jitendraphand/ziggy/docs/REFERENCES.md

<!-- SPDX-License-Identifier: CC-BY-4.0 -->
# Primary references (checked 2026-11-07)

* ELEGOO Neptune 4 Max product page and specs (420×420×480 mm): https://www.elegoo.com/products/neptune-4-max-fdm-3d-printer
* ELEGOO Wiki Neptune 4 Max FAQ: https://wiki.elegoo.com/en/faq/neptune-4-max-faq
* CubeMars AK80-64 KV80 (48/120 N·m, 64:1, 850 g, single 14-bit encoder): https://www.cubemars.com/product/ak80-64-kv80-robotic-actuator.html
* CubeMars AK70-10 (8.3/24.8 N·m; AK series table on the same site): https://www.cubemars.com/
* RobStride 04 user manual (40/120 N·m, 9:1, dual encoders, 15–60 VDC): https://torquemicro.com/products/robstride-04-motor
* MuJoCo documentation: https://mujoco.readthedocs.io/ and repository https://github.com/google-deepmind/mujoco
* CadQuery documentation: https://cadquery.readthedocs.io/ and repository https://github.com/CadQuery/cadquery
* CERN-OHL-S v2: https://ohwr.org/cern_ohl_s_v2.txt · Apache-2.0: https://www.apache.org/licenses/LICENSE-2.0
* ISO 13482 (personal care robots, safety) and ISO 10218 (industrial robots): standards for guidance; not reproduced here
* CubeMars AK80-64 2D drawing (interface dims used in cad/lower_body.py): https://www.cubemars.com/data/cms/202602/ak80-64-robotic-actuator-2d-drawing.pdf
* SKF 6004-2RSH deep groove ball bearing (20×42×12, C 9.95 kN, C0 5 kN): https://www.skf.com/
* Unitree H1 public specifications (benchmark reference only): https://www.unitree.com/h1 and https://support.unitree.com/
