jitendraphand/ziggy/media/push_com_trace.png

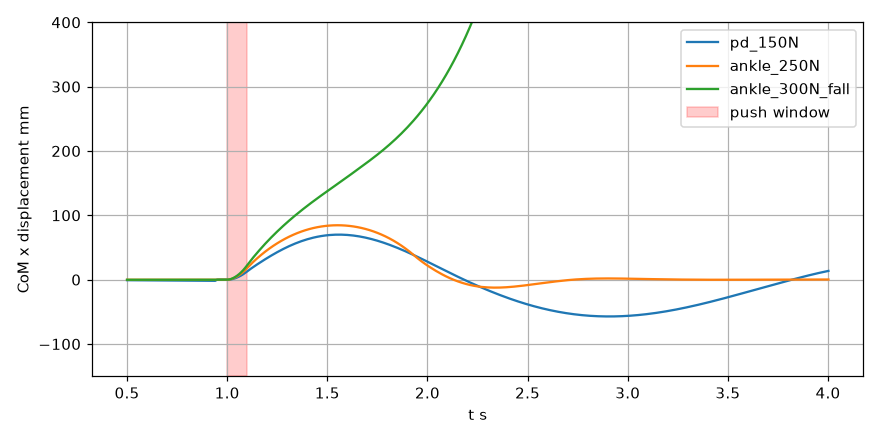
media/push_com_trace.png
