jitendraphand/ziggy/media/push_compare.png

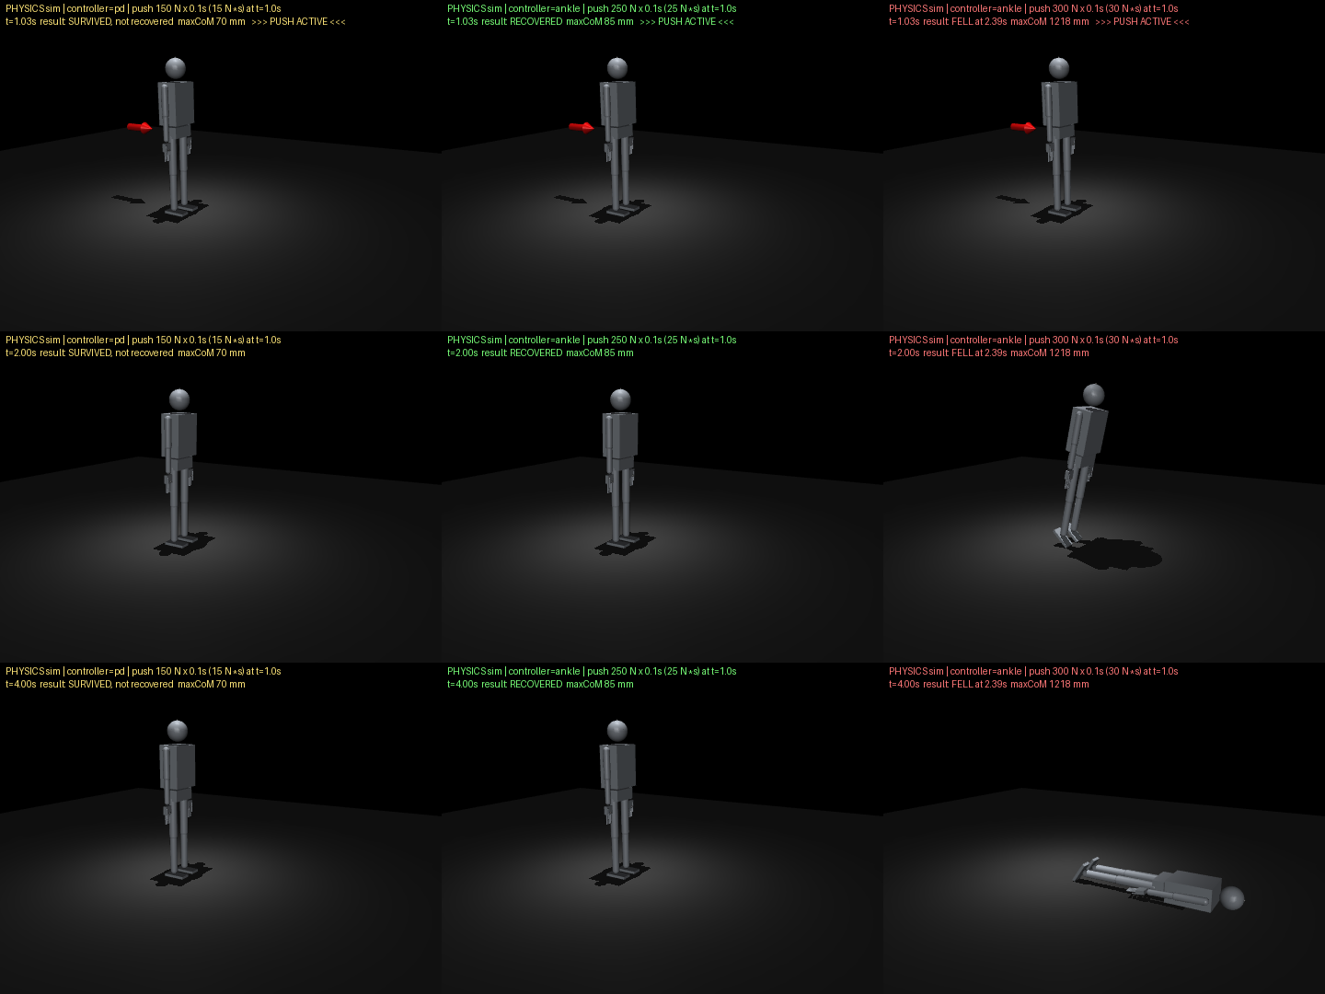
media/push_compare.png
