jitendraphand/ziggy/hardware/lower_body/step/KN-SPC-L.step

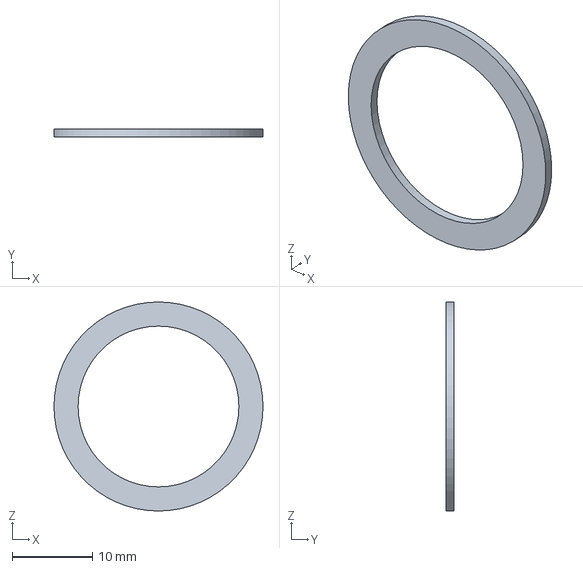
[picture p12: CAD file, 2026-11-07]
hardware/lower_body/step/KN-SPC-L.step
26.0 x 1.00 x 26.0 mm
