jitendraphand/ziggy/hardware/step/forearm_cover_half.step

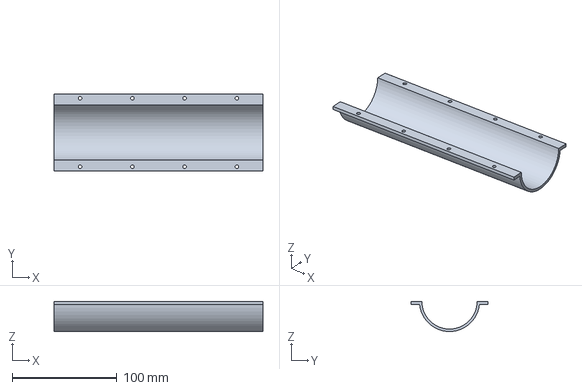
[picture p13: CAD file, 2026-11-07]
hardware/step/forearm_cover_half.step
200.0 x 73.6 x 28.8 mm
