jitendraphand/ziggy/hardware/lower_body/step/HR-BCOV-L.step

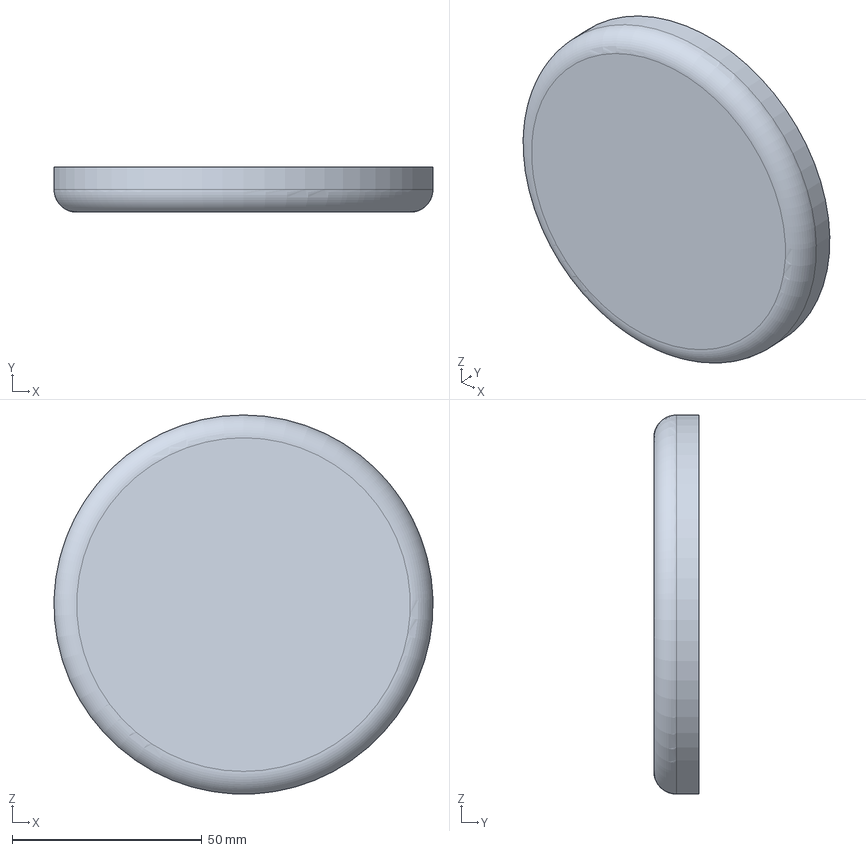
[picture p14: CAD file, 2026-11-07]
hardware/lower_body/step/HR-BCOV-L.step
100.0 x 12.0 x 100.0 mm
