jitendraphand/ziggy/hardware/step/phalanx_distal.step

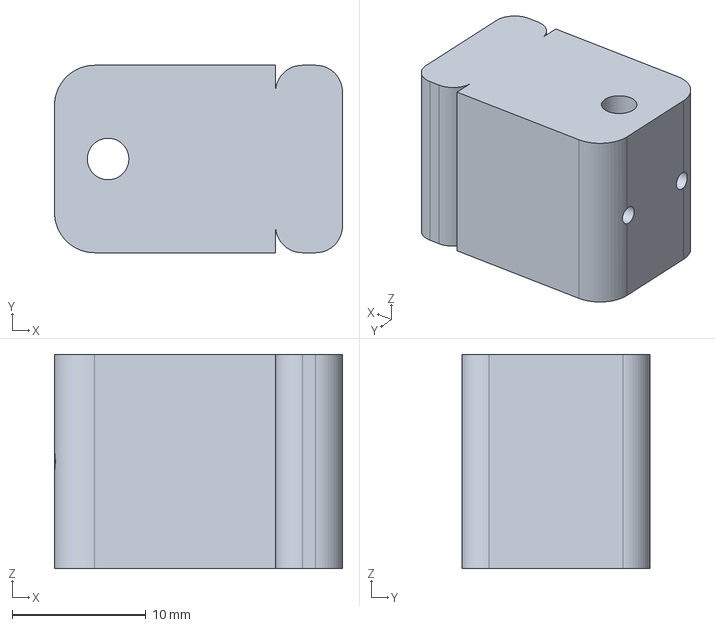
[picture p15: CAD file, 2026-11-07]
hardware/step/phalanx_distal.step
21.5 x 14.0 x 16.0 mm
