jitendraphand/ziggy/hardware/lower_body/step/HR-CAP-L.step

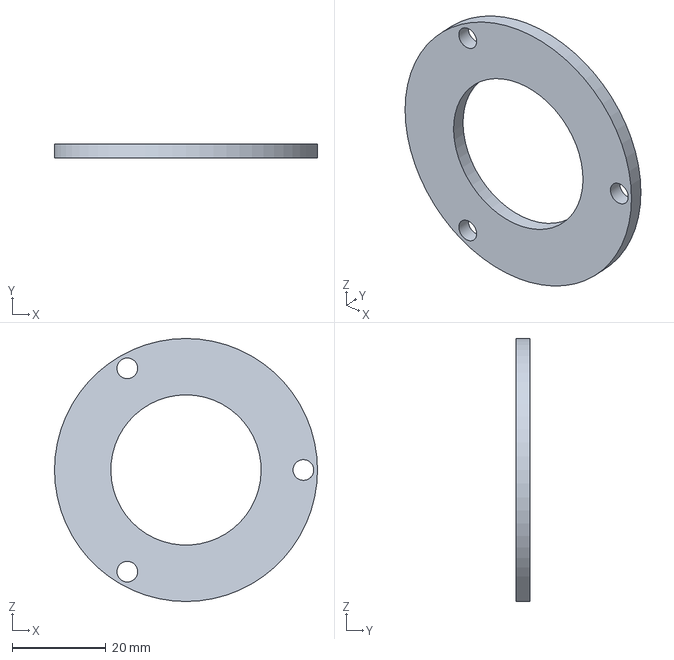
[picture p16: CAD file, 2026-11-07]
hardware/lower_body/step/HR-CAP-L.step
56.0 x 3.00 x 56.0 mm
