jitendraphand/ziggy/hardware/step/coupon_tube_fit.step

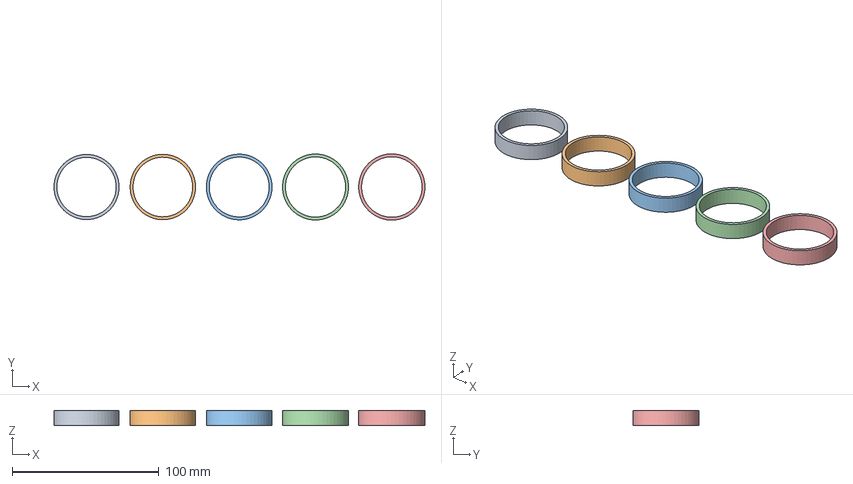
[picture p17: CAD file, 2026-11-07]
hardware/step/coupon_tube_fit.step
252.8 x 45.2 x 10.0 mm
