jitendraphand/ziggy/hardware/lower_body/step/HR-ARA-L.step

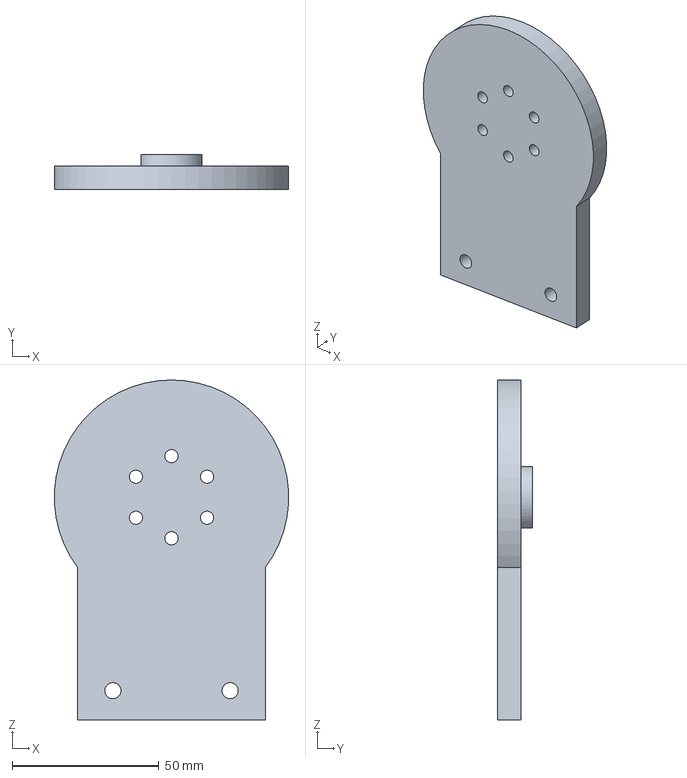
[picture p18: CAD file, 2026-11-07]
hardware/lower_body/step/HR-ARA-L.step
79.9 x 12.0 x 116.0 mm
