jitendraphand/ziggy/hardware/step/pelvis_cover.step

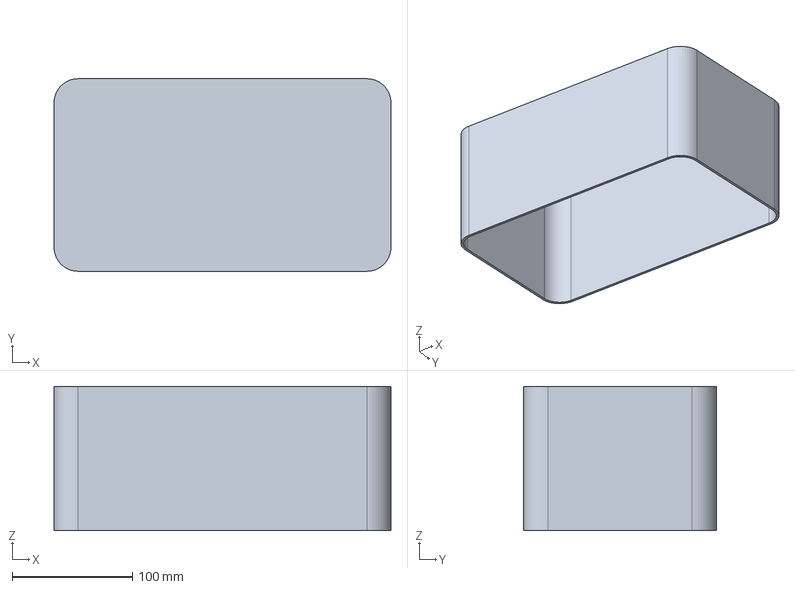
[picture p19: CAD file, 2026-11-07]
hardware/step/pelvis_cover.step
280.0 x 160.0 x 120.0 mm
