jitendraphand/ziggy/hardware/lower_body/step/THIGH-TUBE-L.step

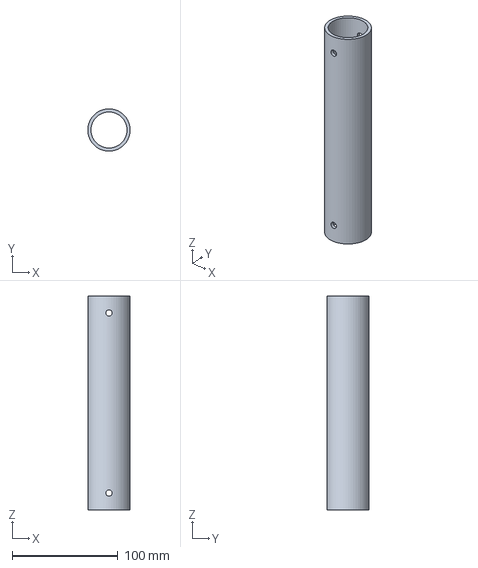
[picture p20: CAD file, 2026-11-07]
hardware/lower_body/step/THIGH-TUBE-L.step
40.0 x 40.0 x 202.0 mm
