jitendraphand/ziggy/hardware/step/coupon_holes.step

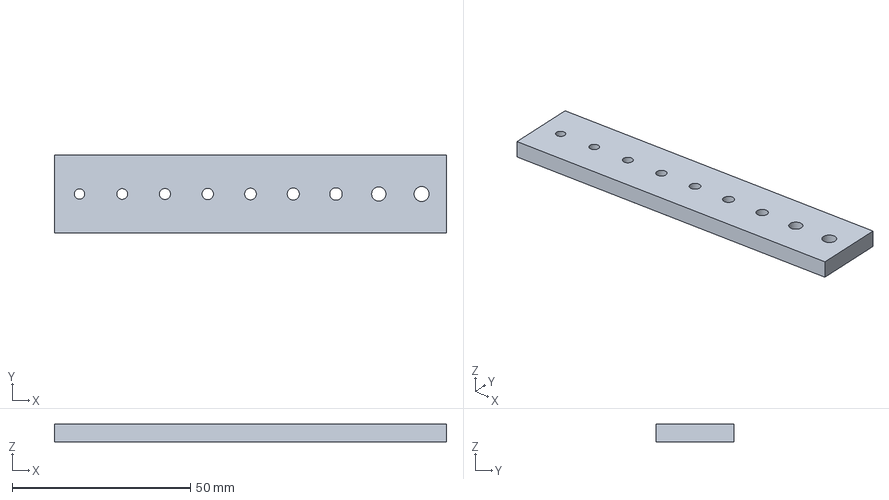
[picture p21: CAD file, 2026-11-07]
hardware/step/coupon_holes.step
110.0 x 22.0 x 5.00 mm
