jitendraphand/ziggy/hardware/lower_body/step/KN-ACT-L.step

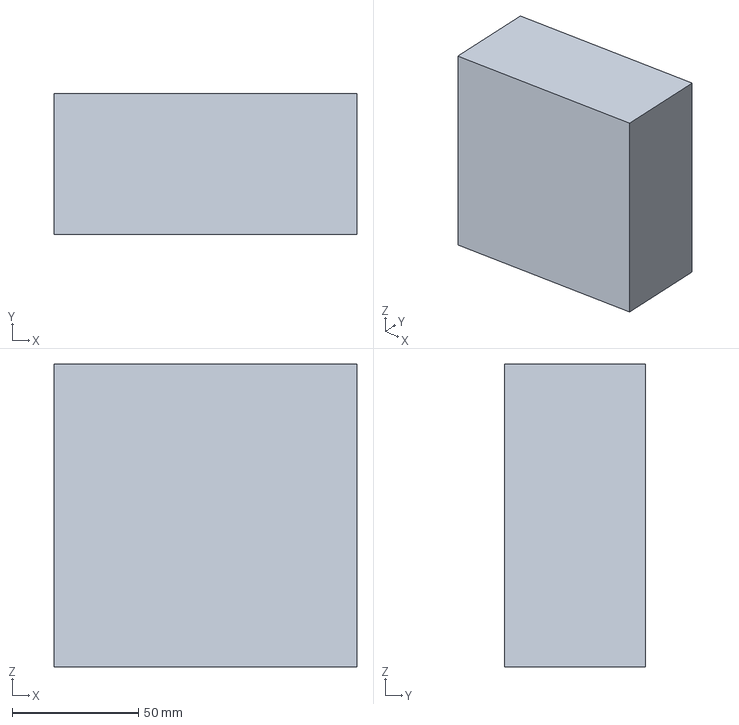
[picture p22: CAD file, 2026-11-07]
hardware/lower_body/step/KN-ACT-L.step
120.0 x 56.0 x 120.0 mm
