jitendraphand/ziggy/hardware/step/estop_mount.step

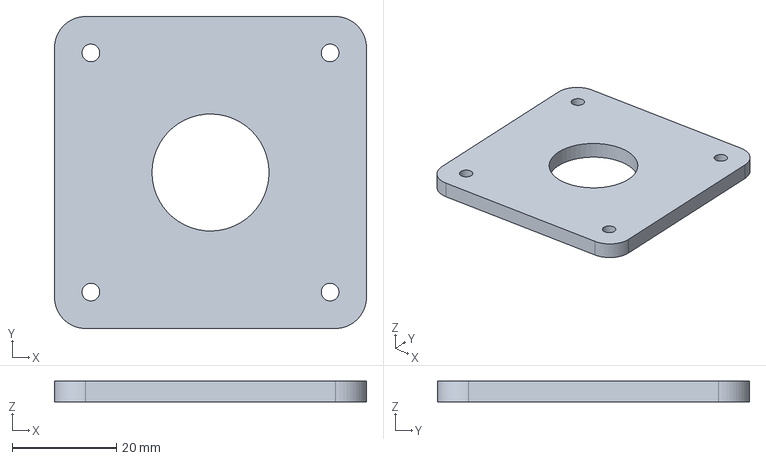
[picture p23: CAD file, 2026-11-07]
hardware/step/estop_mount.step
60.0 x 60.0 x 4.00 mm
