jitendraphand/ziggy/hardware/lower_body/step/KN-PBR-L.step

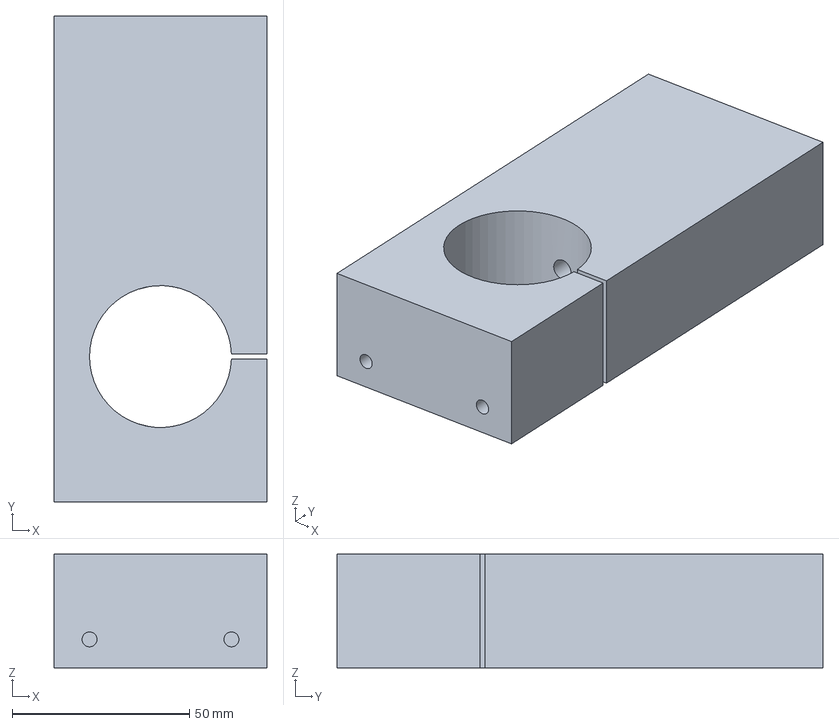
[picture p24: CAD file, 2026-11-07]
hardware/lower_body/step/KN-PBR-L.step
60.0 x 137.0 x 32.0 mm
