jitendraphand/ziggy/hardware/step/phalanx_proximal.step

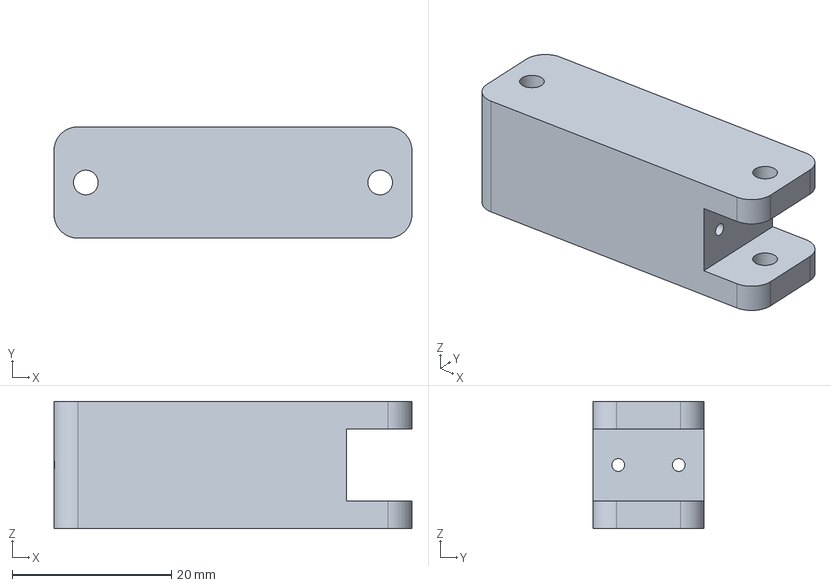
[picture p25: CAD file, 2026-11-07]
hardware/step/phalanx_proximal.step
45.0 x 14.0 x 16.0 mm
