jitendraphand/ziggy/hardware/lower_body/step/AP-PLB-L.step

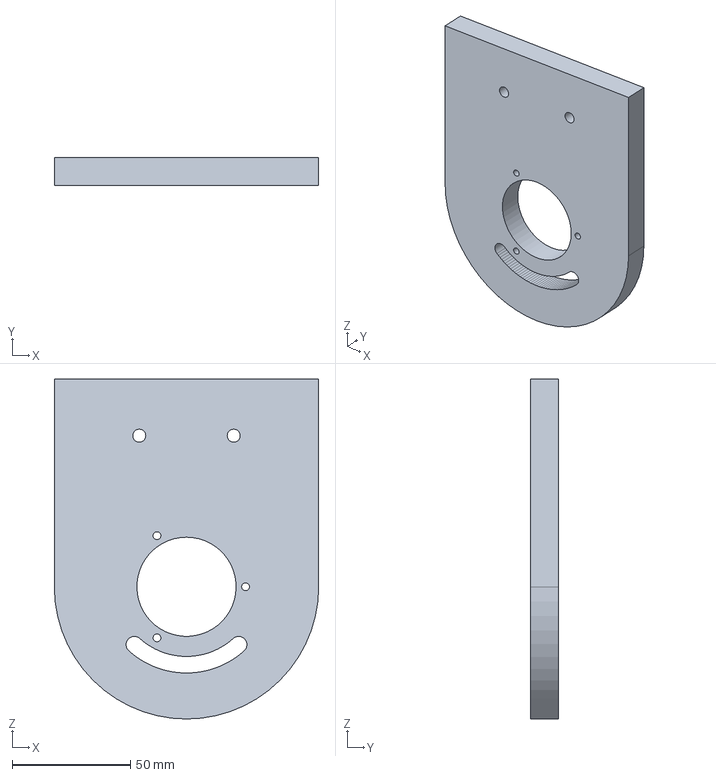
[picture p26: CAD file, 2026-11-07]
hardware/lower_body/step/AP-PLB-L.step
112.0 x 12.0 x 144.0 mm
