jitendraphand/ziggy/hardware/step/foot_cover.step

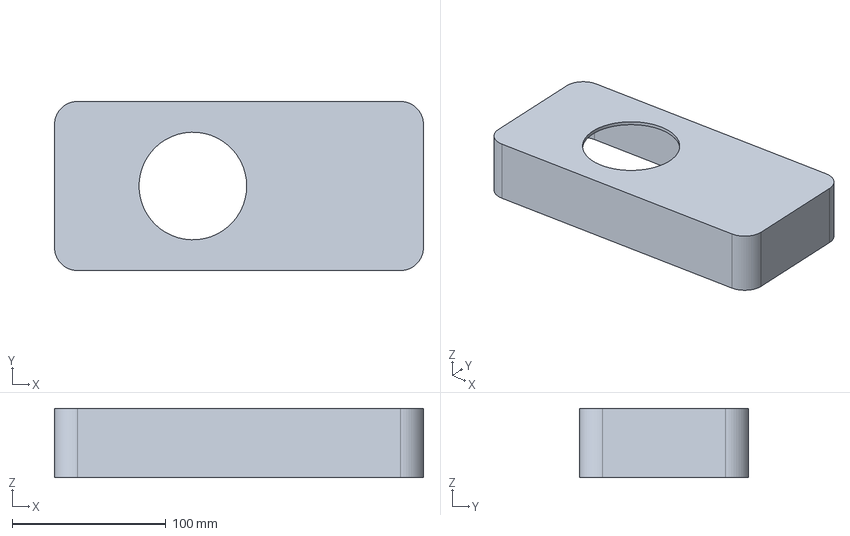
[picture p27: CAD file, 2026-11-07]
hardware/step/foot_cover.step
240.0 x 110.0 x 45.0 mm
