jitendraphand/ziggy/hardware/lower_body/step/KN-BRG-L.step

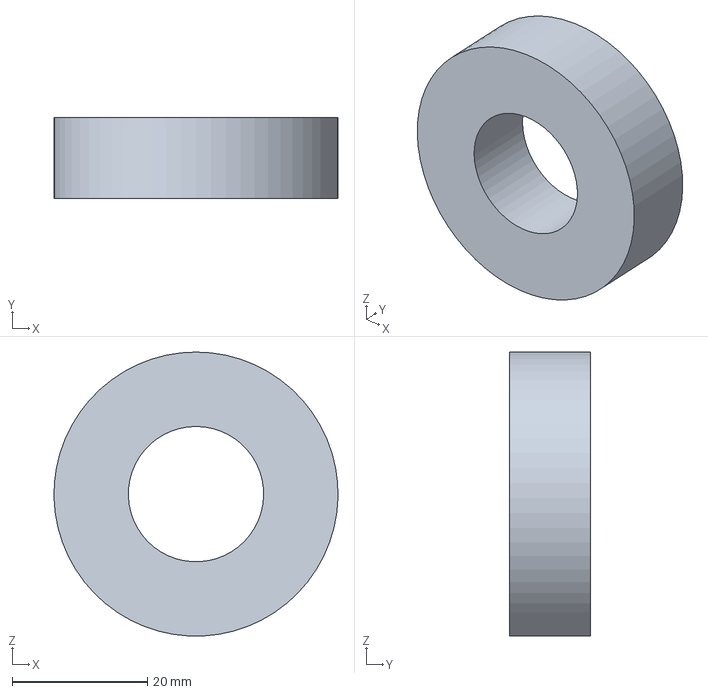
[picture p28: CAD file, 2026-11-07]
hardware/lower_body/step/KN-BRG-L.step
42.0 x 12.0 x 42.0 mm
