jitendraphand/ziggy/hardware/step/torso_shell_front.step

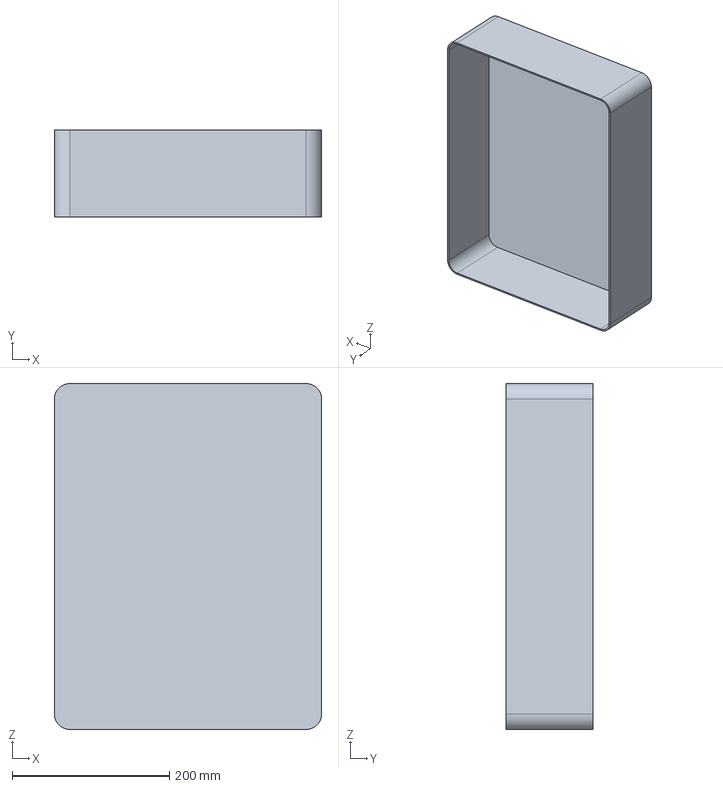
[picture p29: CAD file, 2026-11-07]
hardware/step/torso_shell_front.step
340.0 x 110.0 x 440.0 mm
