jitendraphand/ziggy/hardware/lower_body/step/SHIN-TUBE-L.step

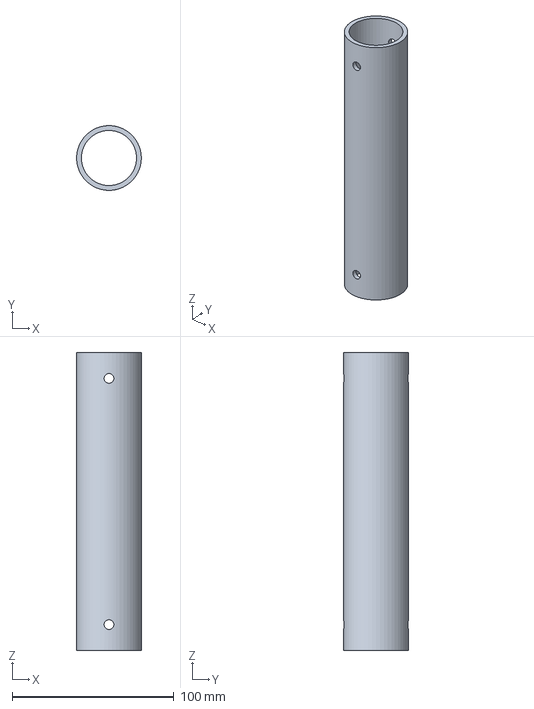
[picture p30: CAD file, 2026-11-07]
hardware/lower_body/step/SHIN-TUBE-L.step
40.0 x 40.0 x 184.0 mm
