jitendraphand/ziggy/hardware/step/upper_arm_cover_half.step

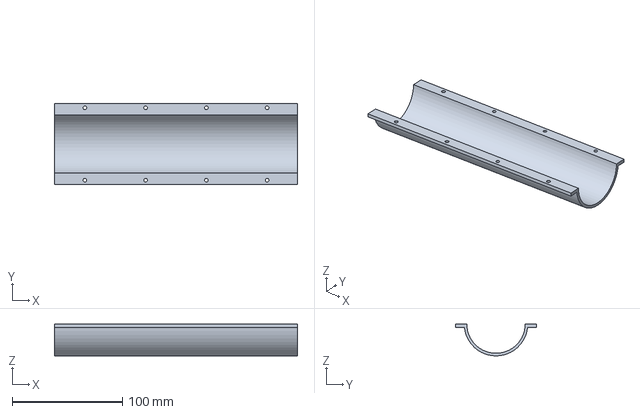
[picture p31: CAD file, 2026-11-07]
hardware/step/upper_arm_cover_half.step
220.0 x 73.6 x 28.8 mm
