jitendraphand/ziggy/hardware/lower_body/step/HP-PLA-L.step

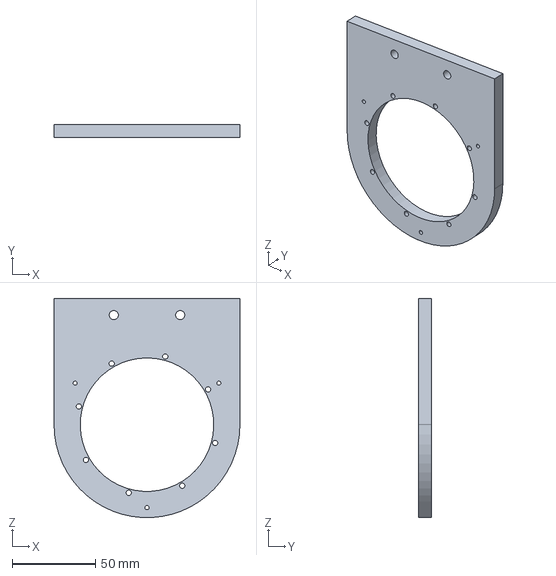
[picture p32: CAD file, 2026-11-07]
hardware/lower_body/step/HP-PLA-L.step
112.0 x 8.00 x 131.9 mm
