jitendraphand/ziggy/hardware/step/actuator_cover_ak80.step

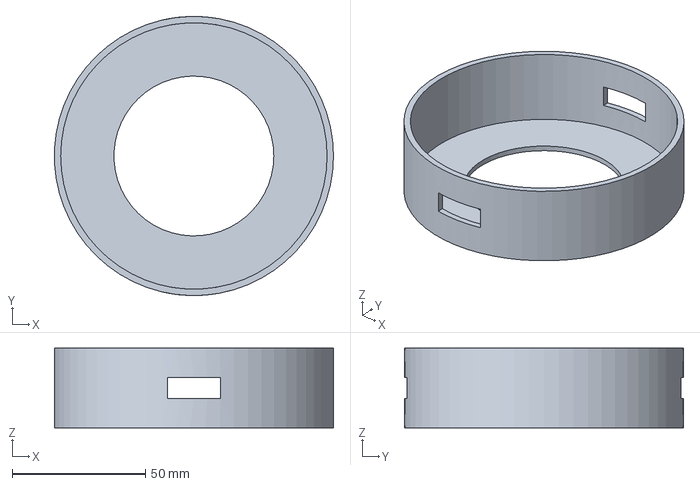
[picture p33: CAD file, 2026-11-07]
hardware/step/actuator_cover_ak80.step
104.7 x 104.8 x 30.0 mm
