jitendraphand/ziggy/hardware/lower_body/step/HR-PBR-L.step

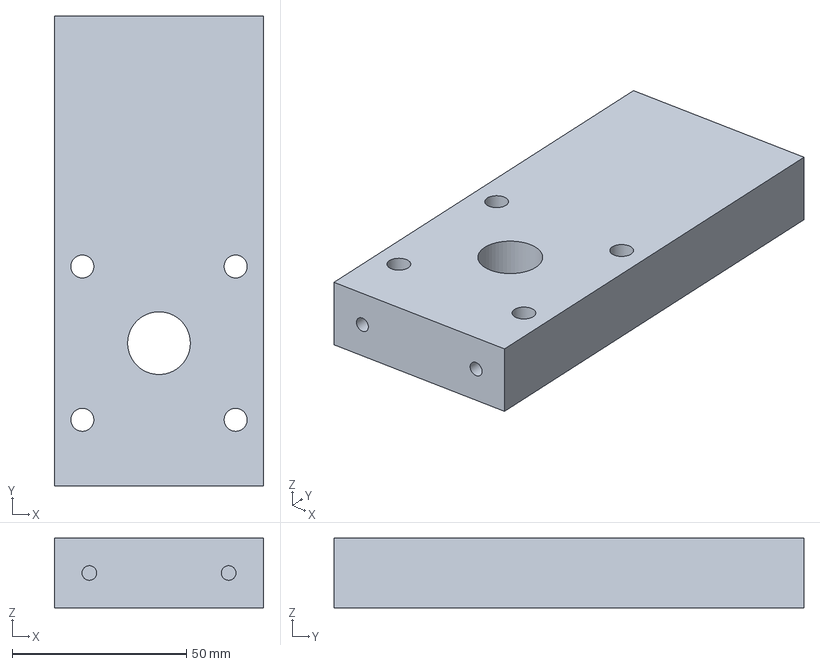
[picture p34: CAD file, 2026-11-07]
hardware/lower_body/step/HR-PBR-L.step
60.0 x 134.9 x 20.0 mm
