jitendraphand/ziggy/hardware/lower_body/step/HP-RCAP-L.step

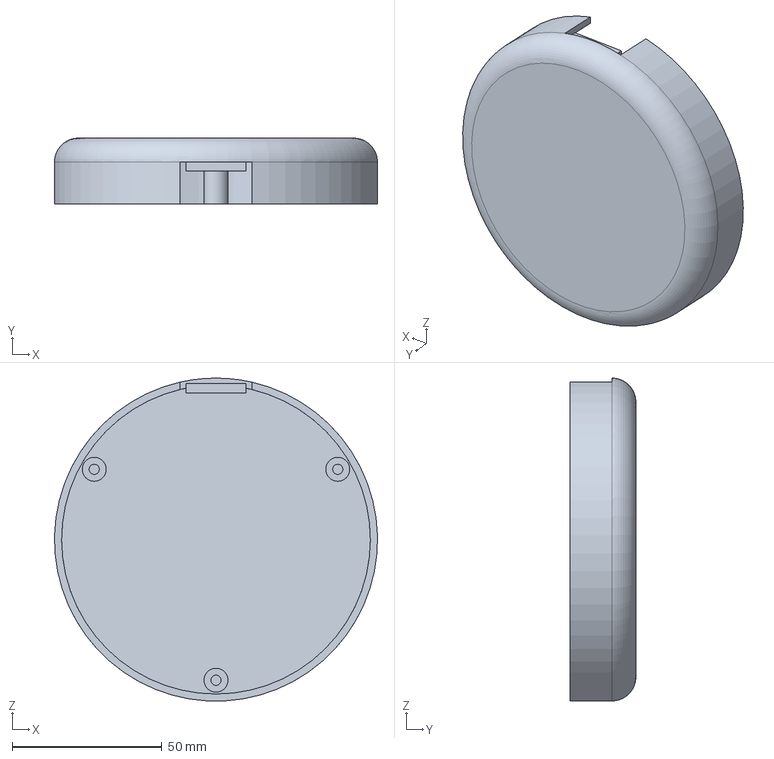
[picture p35: CAD file, 2026-11-07]
hardware/lower_body/step/HP-RCAP-L.step
108.0 x 22.0 x 107.9 mm
