jitendraphand/ziggy/hardware/step/cable_clip_tube40.step

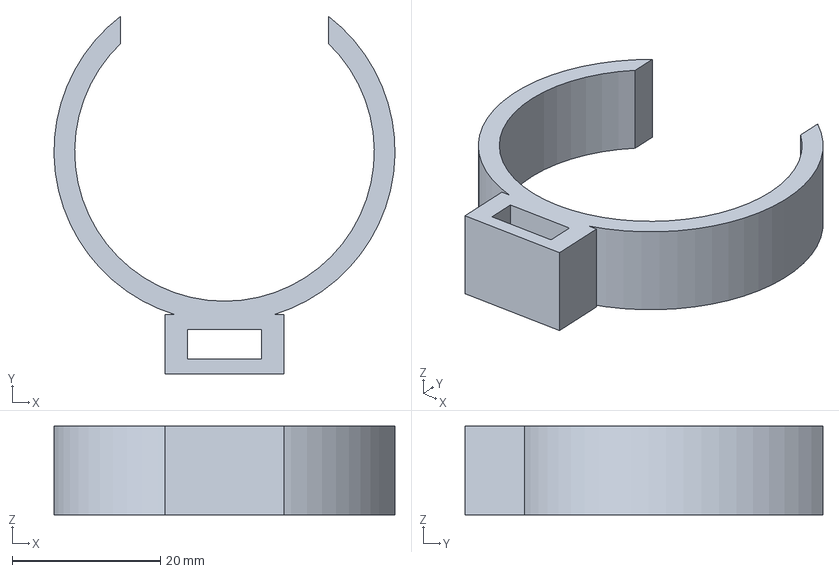
[picture p36: CAD file, 2026-11-07]
hardware/step/cable_clip_tube40.step
46.0 x 48.2 x 12.0 mm
