jitendraphand/ziggy/hardware/lower_body/step/AR-DBR-L.step

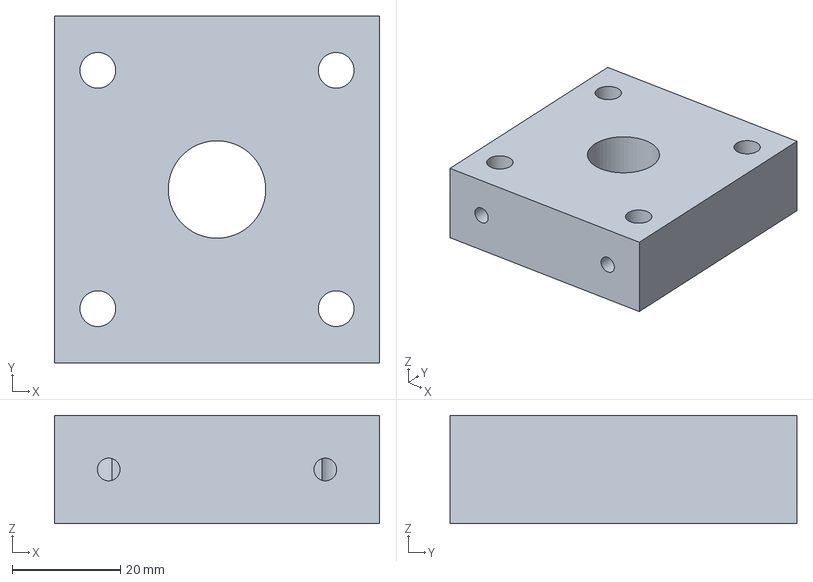
[picture p37: CAD file, 2026-11-07]
hardware/lower_body/step/AR-DBR-L.step
60.0 x 64.0 x 20.0 mm
