jitendraphand/ziggy/hardware/step/thigh_cover_half.step

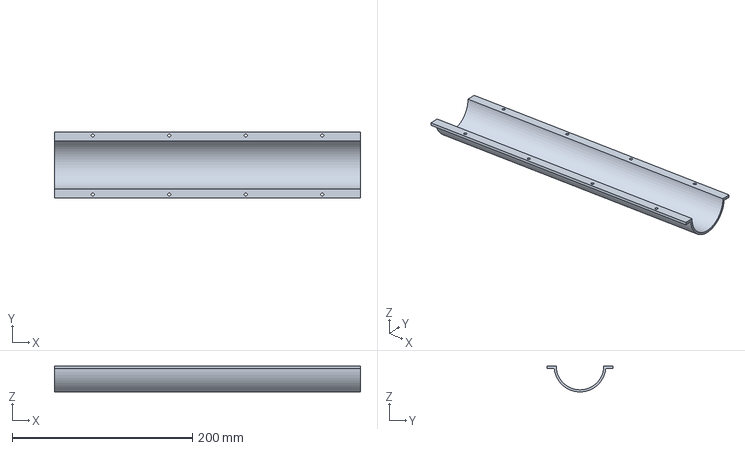
[picture p38: CAD file, 2026-11-07]
hardware/step/thigh_cover_half.step
340.0 x 73.6 x 28.8 mm
