jitendraphand/ziggy/hardware/step/head_shell_half.step

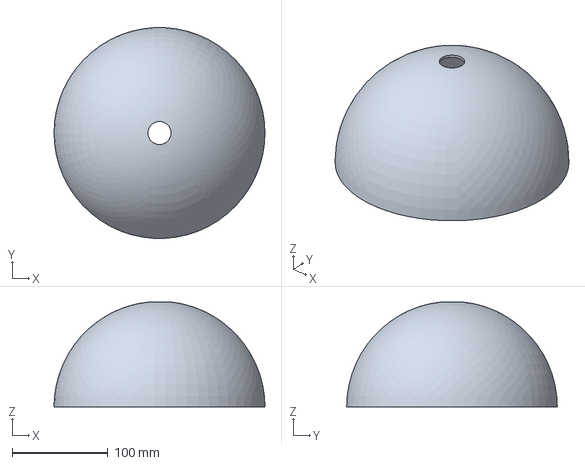
[picture p39: CAD file, 2026-11-07]
hardware/step/head_shell_half.step
220.0 x 219.7 x 109.3 mm
