jitendraphand/ziggy/hardware/lower_body/step/KN-DBR-L.step

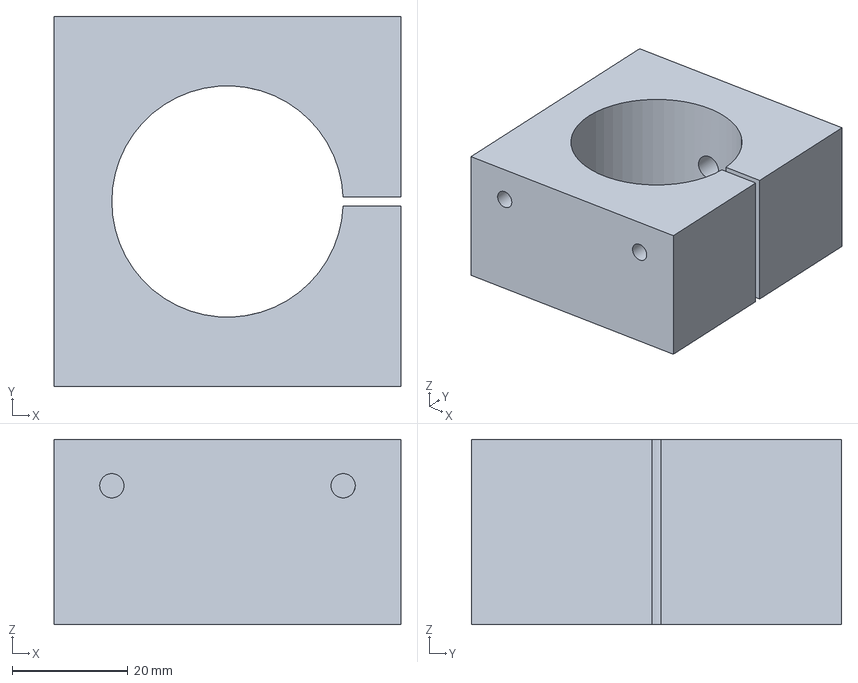
[picture p40: CAD file, 2026-11-07]
hardware/lower_body/step/KN-DBR-L.step
60.0 x 64.0 x 32.0 mm
