jitendraphand/ziggy/hardware/step/foot_sole_pad.step

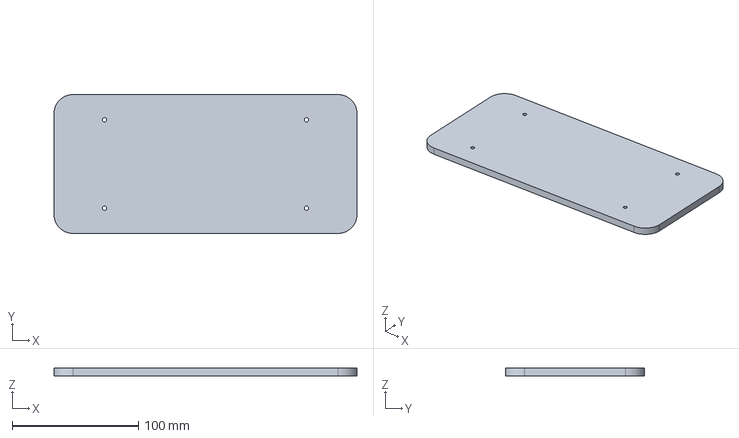
[picture p41: CAD file, 2026-11-07]
hardware/step/foot_sole_pad.step
240.0 x 110.0 x 6.00 mm
