jitendraphand/ziggy/hardware/step/shin_cover_half.step

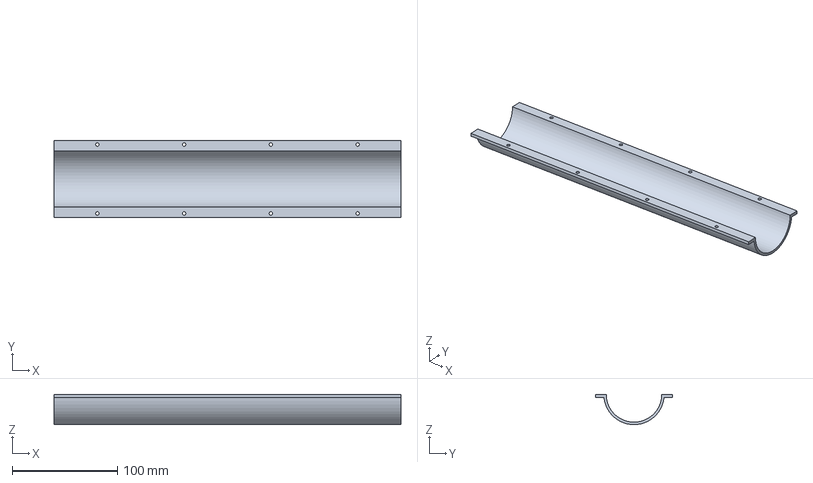
[picture p42: CAD file, 2026-11-07]
hardware/step/shin_cover_half.step
330.0 x 73.6 x 28.8 mm
