jitendraphand/ziggy/hardware/lower_body/step/KN-ARB-L.step

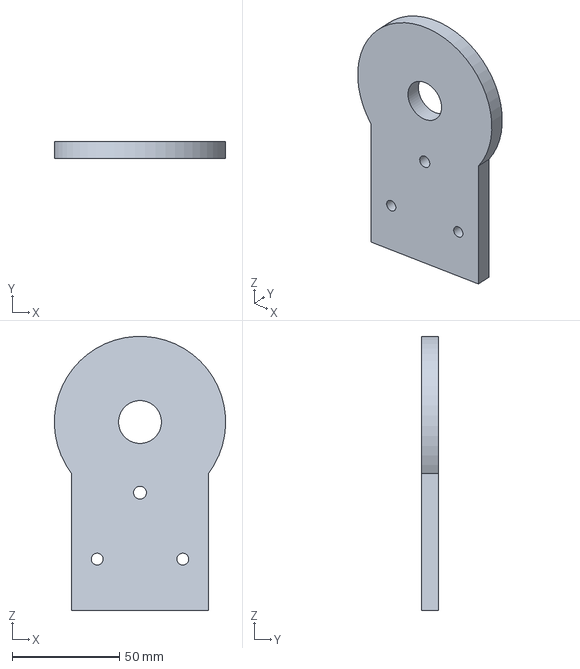
[picture p43: CAD file, 2026-11-07]
hardware/lower_body/step/KN-ARB-L.step
79.9 x 8.00 x 127.9 mm
