jitendraphand/ziggy/hardware/step/phalanx_middle.step

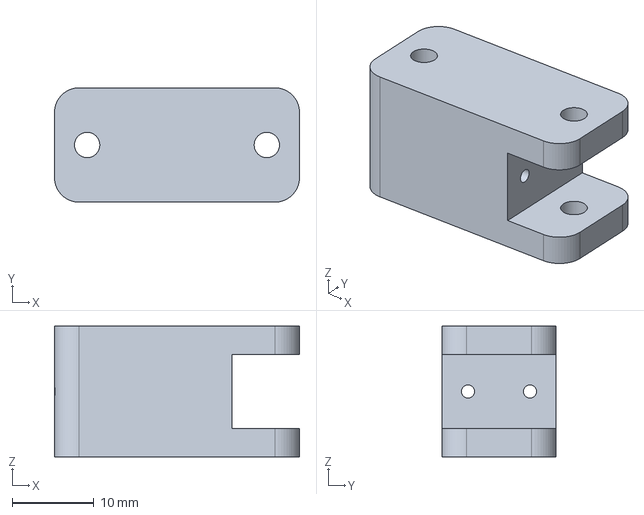
[picture p44: CAD file, 2026-11-07]
hardware/step/phalanx_middle.step
30.0 x 14.0 x 16.0 mm
