jitendraphand/ziggy/hardware/lower_body/step/KN-PIN-L.step

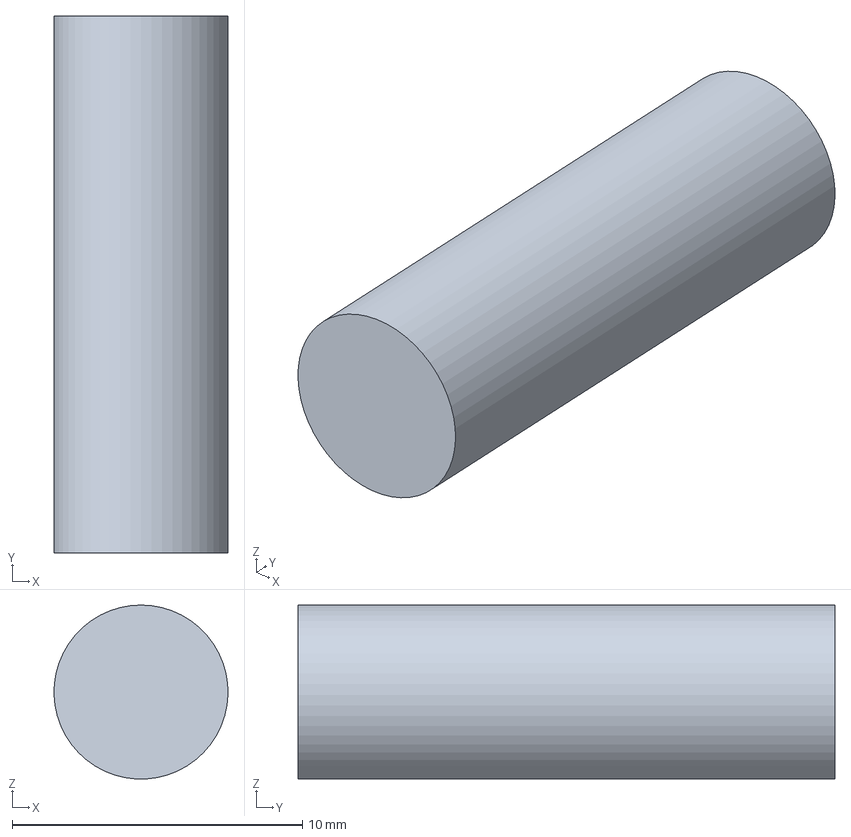
[picture p45: CAD file, 2026-11-07]
hardware/lower_body/step/KN-PIN-L.step
6.00 x 18.5 x 5.99 mm
