jitendraphand/ziggy/hardware/step/tendon_spool.step

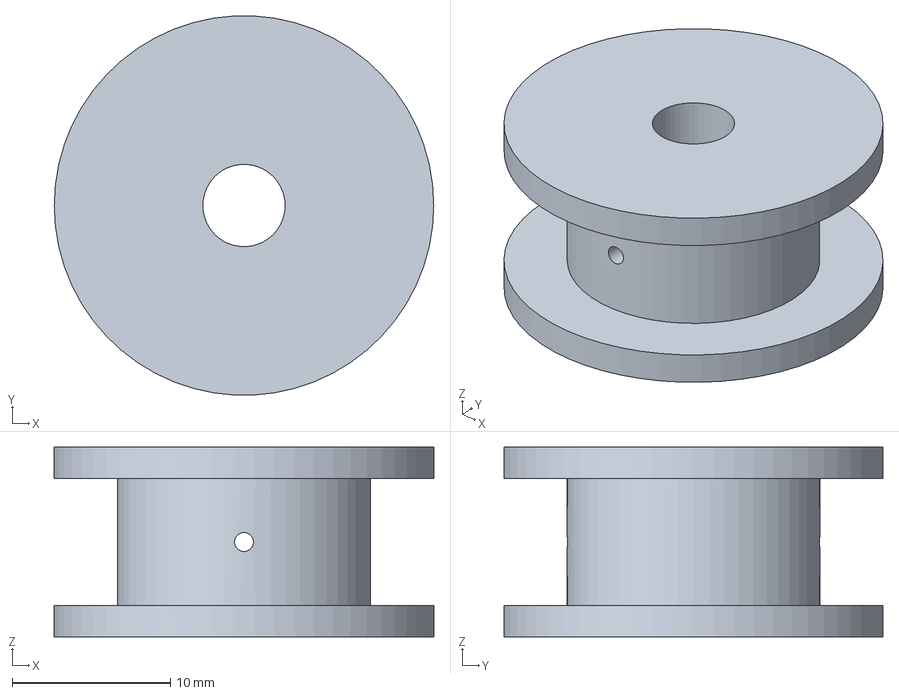
[picture p46: CAD file, 2026-11-07]
hardware/step/tendon_spool.step
24.0 x 24.0 x 12.0 mm
