jitendraphand/ziggy/hardware/lower_body/step/KN-CLP-L.step

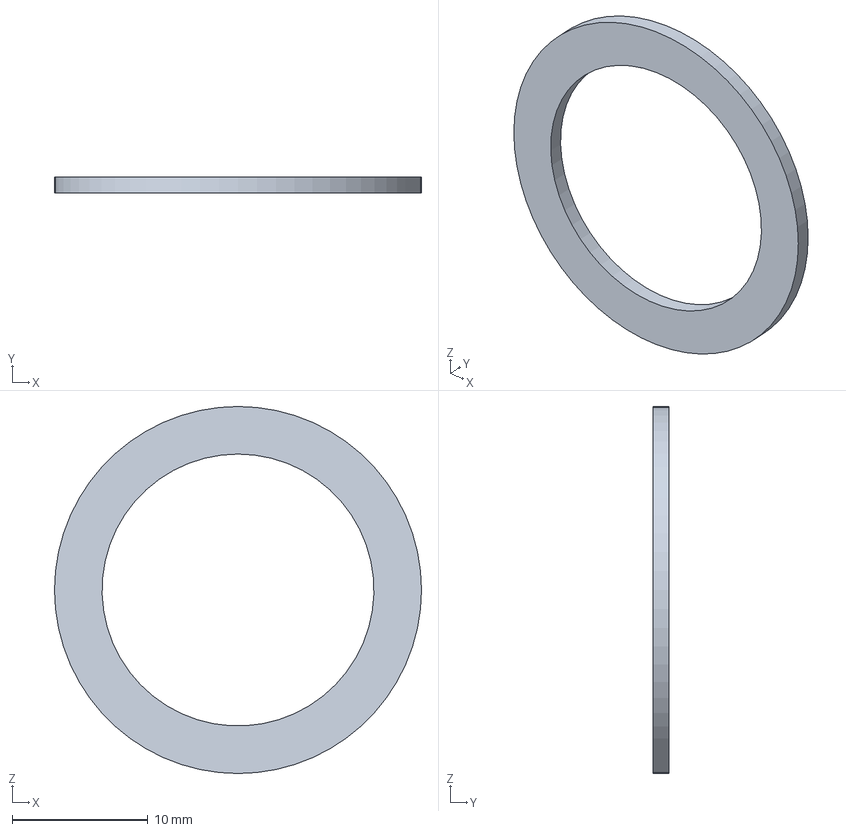
[picture p47: CAD file, 2026-11-07]
hardware/lower_body/step/KN-CLP-L.step
27.0 x 1.20 x 27.0 mm
