jitendraphand/ziggy/hardware/step/palm_base.step

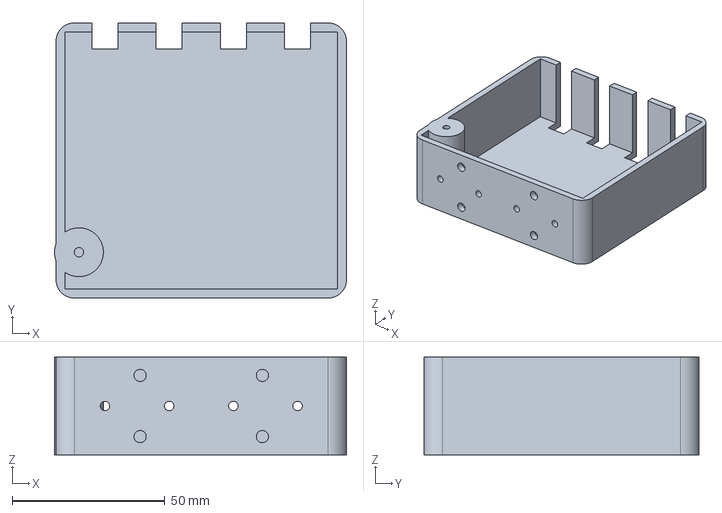
[picture p48: CAD file, 2026-11-07]
hardware/step/palm_base.step
95.5 x 90.0 x 32.0 mm
