jitendraphand/ziggy/hardware/lower_body/step/PELVIS-PLATE.step

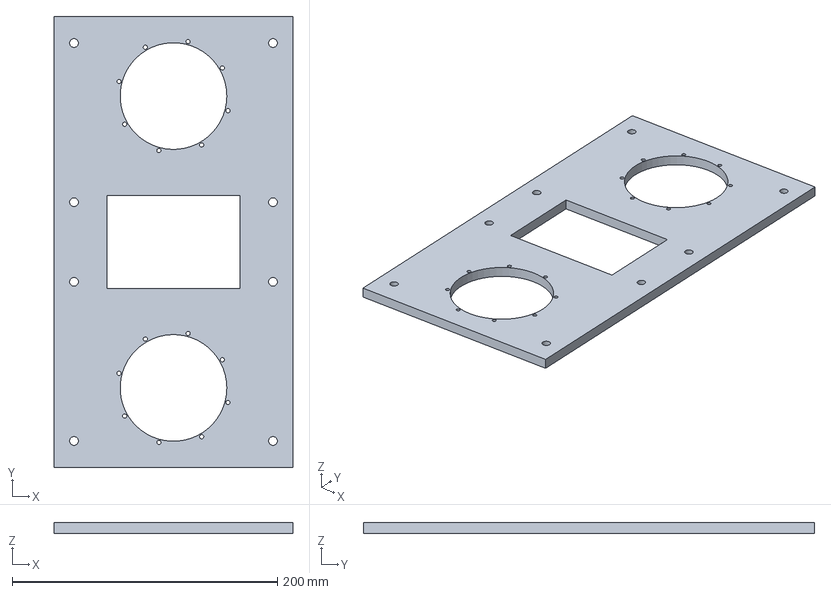
[picture p49: CAD file, 2026-11-07]
hardware/lower_body/step/PELVIS-PLATE.step
180.0 x 340.0 x 8.00 mm
