jitendraphand/ziggy/hardware/lower_body/step/KN-PLB-L.step

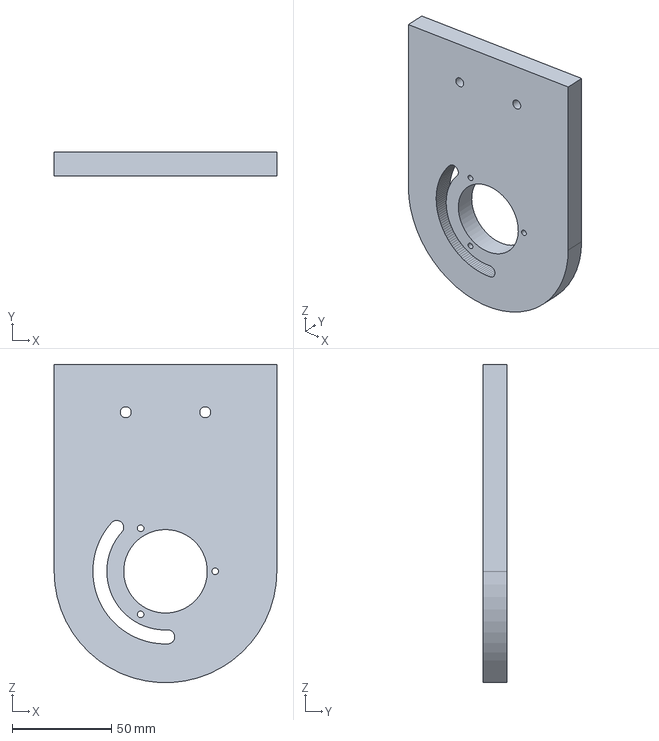
[picture p50: CAD file, 2026-11-07]
hardware/lower_body/step/KN-PLB-L.step
112.0 x 12.0 x 159.9 mm
