jitendraphand/ziggy/hardware/lower_body/step/HR-ACT-L.step

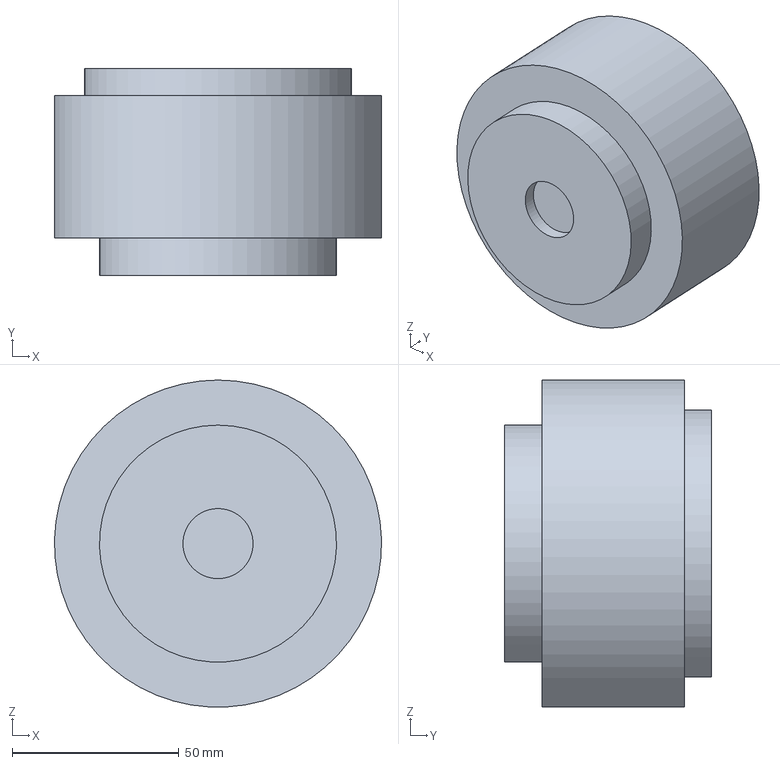
[picture p51: CAD file, 2026-11-07]
hardware/lower_body/step/HR-ACT-L.step
98.0 x 61.9 x 97.9 mm
