jitendraphand/ziggy/hardware/lower_body/step/AP-SFT-L.step

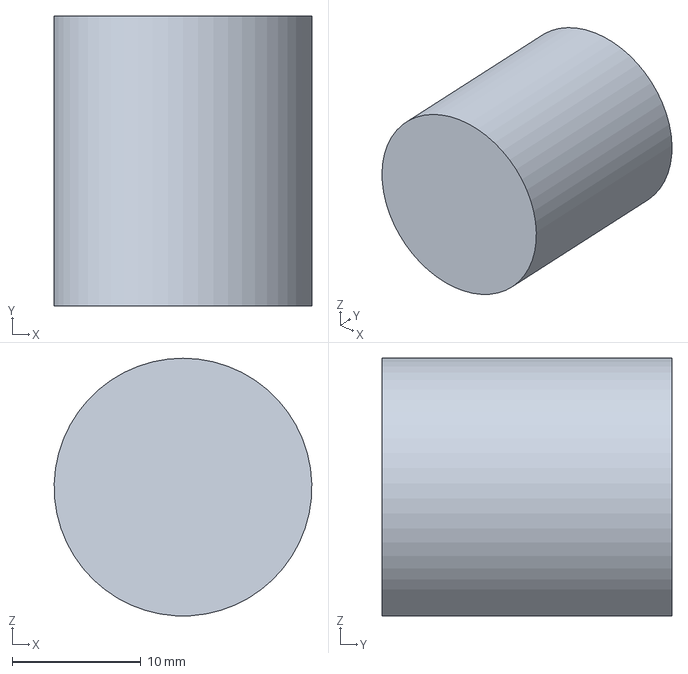
[picture p52: CAD file, 2026-11-07]
hardware/lower_body/step/AP-SFT-L.step
20.0 x 22.5 x 20.0 mm
