jitendraphand/ziggy/hardware/lower_body/step/AR-ARB-L.step

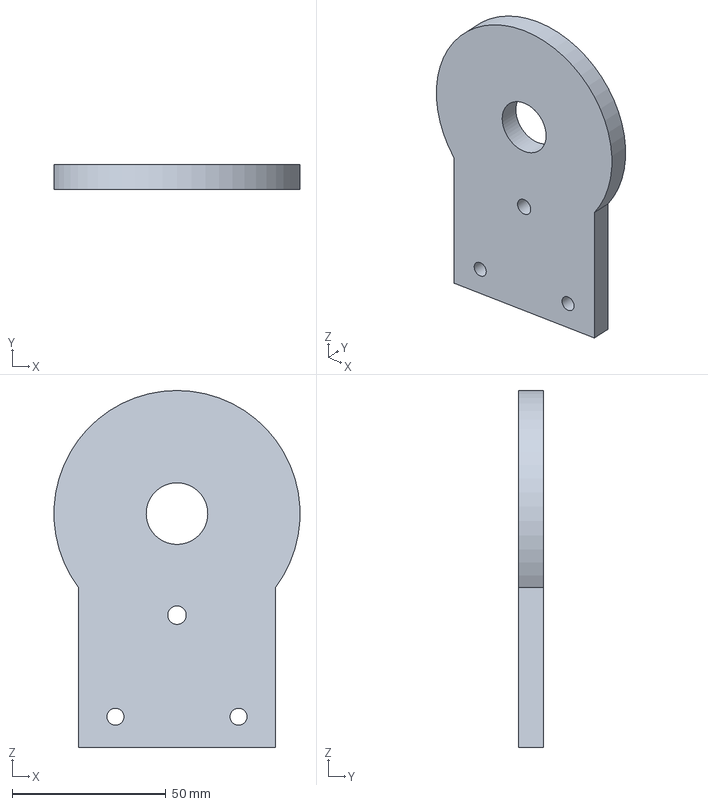
[picture p53: CAD file, 2026-11-07]
hardware/lower_body/step/AR-ARB-L.step
79.9 x 8.00 x 116.0 mm
