jitendraphand/ziggy/hardware/lower_body/step/HR-PLB-L.step

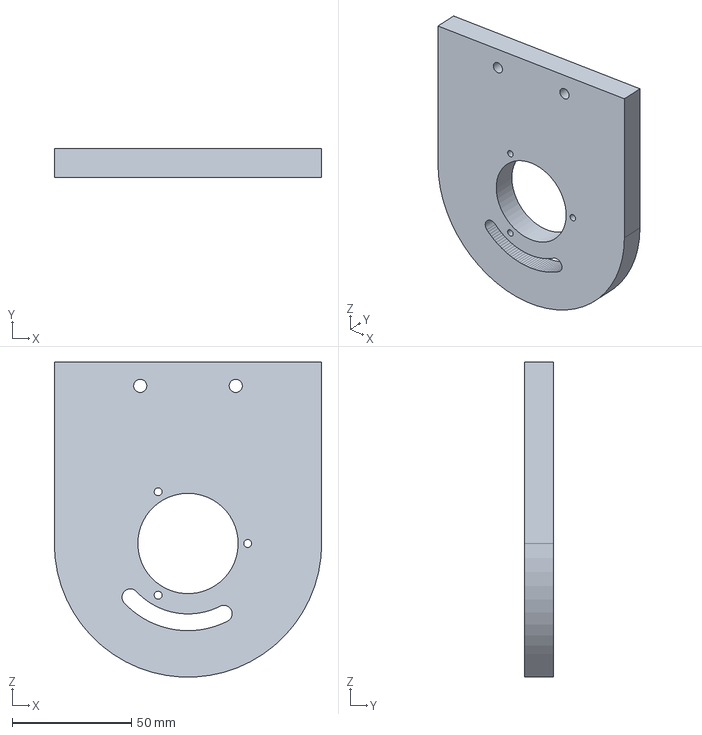
[picture p54: CAD file, 2026-11-07]
hardware/lower_body/step/HR-PLB-L.step
112.0 x 12.0 x 131.9 mm
