jitendraphand/ziggy/hardware/lower_body/step/HY-OUT-L.step

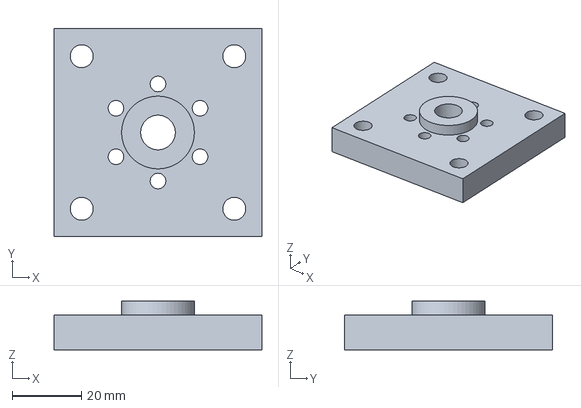
[picture p56: CAD file, 2026-11-07]
hardware/lower_body/step/HY-OUT-L.step
60.0 x 60.0 x 14.0 mm
