jitendraphand/ziggy/hardware/lower_body/step/HP-ARA-L.step

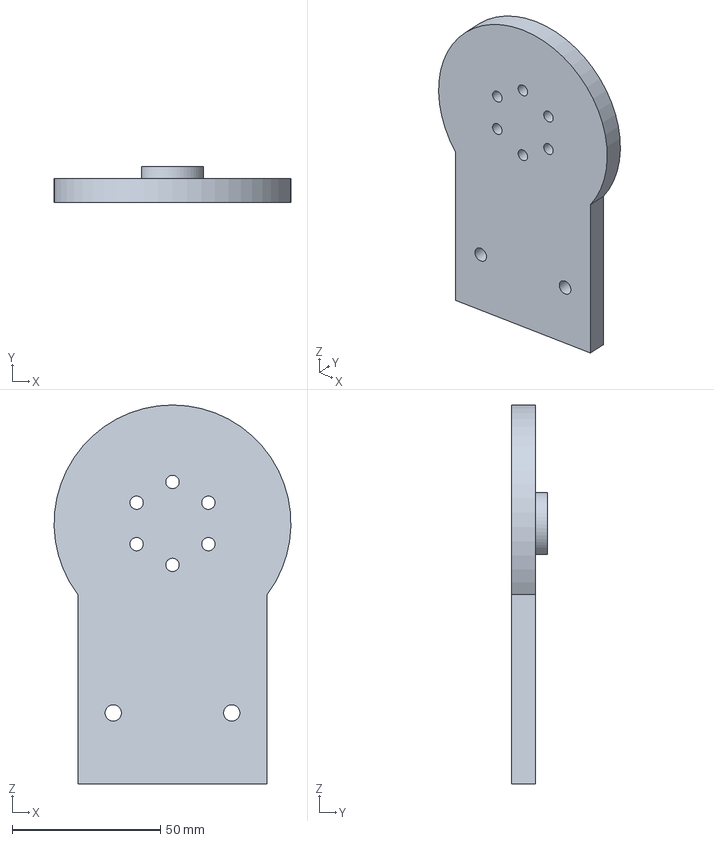
[picture p57: CAD file, 2026-11-07]
hardware/lower_body/step/HP-ARA-L.step
80.0 x 12.0 x 128.0 mm
