jitendraphand/ziggy/hardware/lower_body/step/AP-PBR-L.step

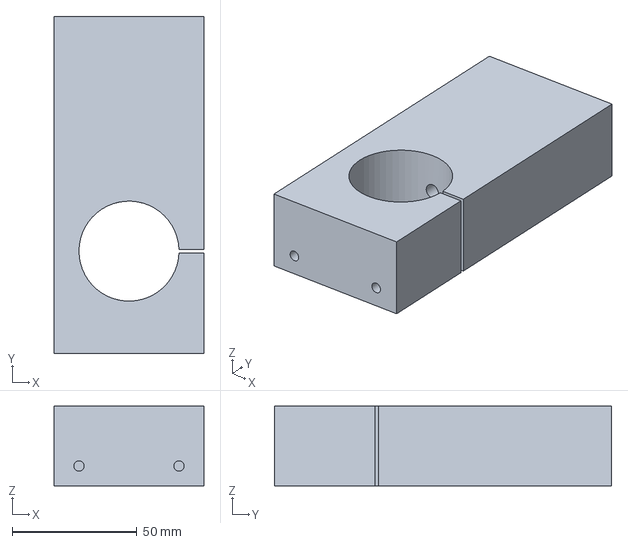
[picture p58: CAD file, 2026-11-07]
hardware/lower_body/step/AP-PBR-L.step
60.0 x 134.9 x 32.0 mm
