jitendraphand/ziggy/hardware/lower_body/step/FOOT-PLATE-L.step

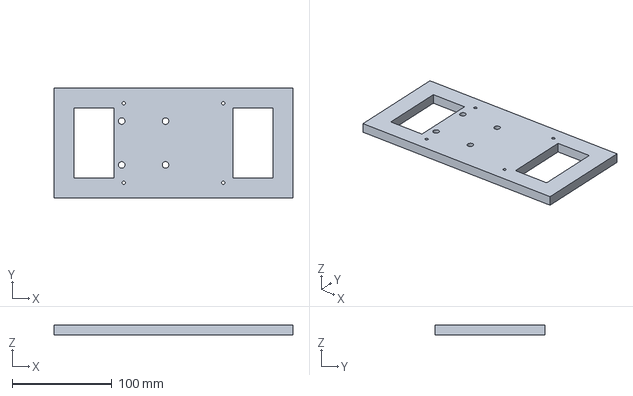
[picture p59: CAD file, 2026-11-07]
hardware/lower_body/step/FOOT-PLATE-L.step
240.0 x 110.0 x 10.0 mm
