jitendraphand/ziggy/hardware/lower_body/step/AP-PLA-L.step

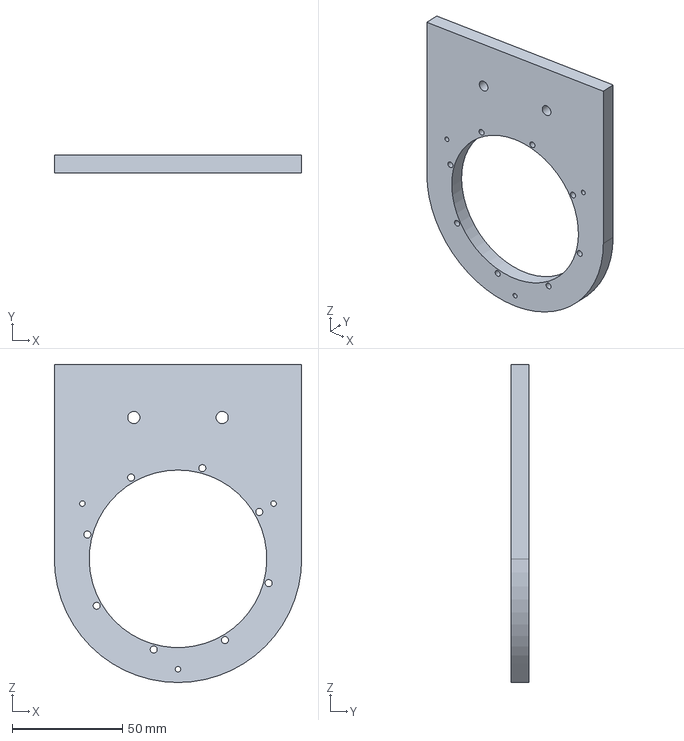
[picture p60: CAD file, 2026-11-07]
hardware/lower_body/step/AP-PLA-L.step
112.0 x 8.00 x 144.0 mm
