jitendraphand/ziggy/hardware/lower_body/step/KN-PLA-L.step

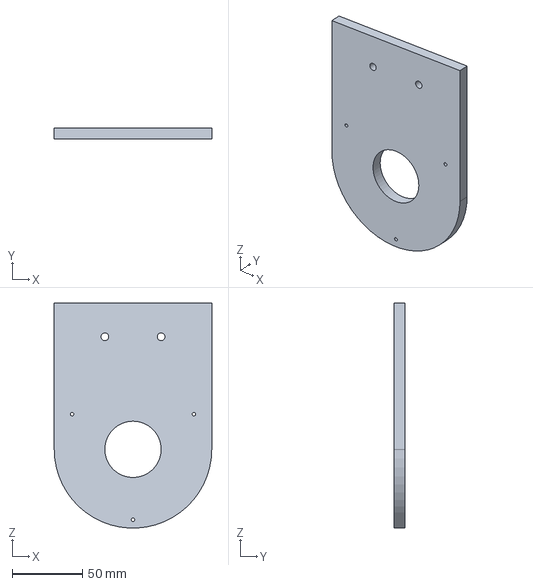
[picture p61: CAD file, 2026-11-07]
hardware/lower_body/step/KN-PLA-L.step
112.0 x 8.00 x 159.9 mm
