jitendraphand/ziggy/(list of files, cad)

Other CAD files:
hardware/step/torso_shell_back.step
hardware/lower_body/step/AR-BRG-L.step
hardware/lower_body/step/AP-ARA-L.step
hardware/lower_body/step/HP-ACT-L.step
hardware/lower_body/step/HR-PIN-L.step
hardware/lower_body/step/HP-BCOV-L.step
hardware/lower_body/step/HP-PBR-L.step
hardware/lower_body/step/KN-SFT-L.step
hardware/lower_body/step/AR-PBR-L.step
hardware/lower_body/step/AP-BCOV-L.step
hardware/lower_body/step/KN-BCOV-L.step
hardware/lower_body/step/HR-SPC-L.step
hardware/lower_body/step/AR-CLP-L.step
hardware/lower_body/step/AP-CLP-L.step
hardware/lower_body/step/AR-SFT-L.step
hardware/lower_body/step/AP-DBR-L.step
hardware/lower_body/step/KN-ARA-L.step
hardware/lower_body/step/AR-RCAP-L.step
hardware/lower_body/step/HR-PLA-L.step
hardware/lower_body/step/AR-PLB-L.step
hardware/lower_body/step/KN-CAP-L.step
hardware/lower_body/step/AP-CAP-L.step
hardware/lower_body/step/AR-SPC-L.step
hardware/lower_body/step/HP-CLP-L.step
hardware/lower_body/step/HR-SFT-L.step
hardware/lower_body/step/HP-ARB-L.step
hardware/lower_body/step/AR-PIN-L.step
hardware/lower_body/step/HP-SPC-L.step
hardware/lower_body/step/AP-PIN-L.step
hardware/lower_body/step/AR-BCOV-L.step
hardware/lower_body/step/HR-RCAP-L.step
hardware/lower_body/step/AP-RCAP-L.step
hardware/lower_body/step/HR-CLP-L.step
hardware/lower_body/step/HP-BRG-L.step
hardware/lower_body/step/HP-PIN-L.step
hardware/lower_body/step/AP-SPC-L.step
hardware/lower_body/step/HP-SFT-L.step
hardware/lower_body/step/HP-DBR-L.step
hardware/lower_body/step/HR-BRG-L.step
hardware/lower_body/step/AP-BRG-L.step
hardware/lower_body/step/AR-CAP-L.step
hardware/lower_body/step/AR-ARA-L.step
hardware/lower_body/step/AP-ACT-L.step
hardware/lower_body/step/AP-ARB-L.step
hardware/lower_body/step/HY-ACT-L.step
hardware/lower_body/step/HR-DBR-L.step
hardware/lower_body/step/HR-ARB-L.step
hardware/lower_body/step/AR-ACT-L.step
hardware/lower_body/step/AR-PLA-L.step
hardware/lower_body/step/HP-CAP-L.step
hardware/lower_body/stl/AP-ARA-L.stl
hardware/lower_body/stl/AP-ARB-L.stl
hardware/lower_body/stl/AP-BCOV-L.stl
hardware/lower_body/stl/AP-CAP-L.stl
hardware/lower_body/stl/AP-DBR-L.stl
hardware/lower_body/stl/AP-PBR-L.stl
hardware/lower_body/stl/AP-PIN-L.stl
hardware/lower_body/stl/AP-PLA-L.stl
hardware/lower_body/stl/AP-PLB-L.stl
hardware/lower_body/stl/AP-RCAP-L.stl
hardware/lower_body/stl/AP-SFT-L.stl
hardware/lower_body/stl/AP-SPC-L.stl
hardware/lower_body/stl/AR-ARA-L.stl
hardware/lower_body/stl/AR-ARB-L.stl
hardware/lower_body/stl/AR-BCOV-L.stl
hardware/lower_body/stl/AR-CAP-L.stl
hardware/lower_body/stl/AR-DBR-L.stl
hardware/lower_body/stl/AR-PBR-L.stl
hardware/lower_body/stl/AR-PIN-L.stl
hardware/lower_body/stl/AR-PLA-L.stl
hardware/lower_body/stl/AR-PLB-L.stl
hardware/lower_body/stl/AR-RCAP-L.stl
hardware/lower_body/stl/AR-SFT-L.stl
hardware/lower_body/stl/AR-SPC-L.stl
hardware/lower_body/stl/FOOT-PLATE-L.stl
hardware/lower_body/stl/HP-ARA-L.stl
hardware/lower_body/stl/HP-ARB-L.stl
hardware/lower_body/stl/HP-BCOV-L.stl
hardware/lower_body/stl/HP-CAP-L.stl
hardware/lower_body/stl/HP-DBR-L.stl
hardware/lower_body/stl/HP-PBR-L.stl
hardware/lower_body/stl/HP-PIN-L.stl
hardware/lower_body/stl/HP-PLA-L.stl
hardware/lower_body/stl/HP-PLB-L.stl
hardware/lower_body/stl/HP-RCAP-L.stl
hardware/lower_body/stl/HP-SFT-L.stl
hardware/lower_body/stl/HP-SPC-L.stl
hardware/lower_body/stl/HR-ARA-L.stl
hardware/lower_body/stl/HR-ARB-L.stl
hardware/lower_body/stl/HR-BCOV-L.stl
hardware/lower_body/stl/HR-CAP-L.stl
hardware/lower_body/stl/HR-DBR-L.stl
hardware/lower_body/stl/HR-PBR-L.stl
hardware/lower_body/stl/HR-PIN-L.stl
hardware/lower_body/stl/HR-PLA-L.stl
hardware/lower_body/stl/HR-PLB-L.stl
hardware/lower_body/stl/HR-RCAP-L.stl
hardware/lower_body/stl/HR-SFT-L.stl
hardware/lower_body/stl/HR-SPC-L.stl
hardware/lower_body/stl/HY-OUT-L.stl
hardware/lower_body/stl/KN-ARA-L.stl
hardware/lower_body/stl/KN-ARB-L.stl
hardware/lower_body/stl/KN-BCOV-L.stl
hardware/lower_body/stl/KN-CAP-L.stl
hardware/lower_body/stl/KN-DBR-L.stl
hardware/lower_body/stl/KN-PBR-L.stl
hardware/lower_body/stl/KN-PIN-L.stl
hardware/lower_body/stl/KN-PLA-L.stl
hardware/lower_body/stl/KN-PLB-L.stl
hardware/lower_body/stl/KN-SFT-L.stl
hardware/lower_body/stl/KN-SPC-L.stl
hardware/lower_body/stl/PELVIS-PLATE.stl
hardware/lower_body/stl/SHIN-TUBE-L.stl
hardware/lower_body/stl/THIGH-TUBE-L.stl
hardware/stl/actuator_cover_ak80.stl
hardware/stl/cable_clip_tube40.stl
hardware/stl/coupon_holes.stl
hardware/stl/coupon_tube_fit.stl
hardware/stl/estop_mount.stl
hardware/stl/foot_cover.stl
hardware/stl/foot_sole_pad.stl
hardware/stl/forearm_cover_half.stl
hardware/stl/head_shell_half.stl
hardware/stl/palm_base.stl
hardware/stl/pelvis_cover.stl
hardware/stl/phalanx_distal.stl
hardware/stl/phalanx_middle.stl
hardware/stl/phalanx_proximal.stl
hardware/stl/shin_cover_half.stl
hardware/stl/tendon_spool.stl
hardware/stl/thigh_cover_half.stl
hardware/stl/torso_shell_back.stl
hardware/stl/torso_shell_front.stl
hardware/stl/upper_arm_cover_half.stl
