jitendraphand/ziggy/docs/validation/v0.1.1.md

# Validation report v0.1.1 (simulation & design checks only)

Generated by `tools/qa.py` on 2026-11-07. Rounds used: 1/3. Gate: **PASS**.

**No physical hardware has been built or tested.** Every result below is simulated or geometric.

```json
{
  "env": {
    "python": "3.13.5",
    "mujoco": "4.0.0",
    "cadquery": "2.8.0"
  },
  "ik_left": {
    "n": 200,
    "success_rate": 0.985,
    "median_err_mm": 0.2680165256730036,
    "p95_err_mm": 0.9561096357621904,
    "max_err_mm": 225.2070110484443,
    "limits_respected_rate": 1.0
  },
  "ik_right": {
    "n": 200,
    "success_rate": 1.0,
    "median_err_mm": 0.2583805205798653,
    "p95_err_mm": 0.9232247860202495,
    "max_err_mm": 0.9971433614148609,
    "limits_respected_rate": 1.0
  },
  "household_reach_residual_mm": {
    "kitchen_counter_0.90m": 0.47,
    "dining_table_0.75m": 45.49,
    "upper_shelf_1.40m": 0.06,
    "door_handle_1.00m": 0.03,
    "light_switch_1.20m": 0.18,
    "floor_pickup_0.10m": 689.64
  },
  "pd_stance_5s": {
    "pelvis_drop_m": 0.0034953654426781444,
    "min_cos_tilt": 0.9999935241119117,
    "min_support_margin_m": 0.08916168619301706,
    "final_margin_m": 0.08980500511160361
  },
  "pd_stance_40N_0.1s_push": {
    "pelvis_drop_m": 0.0034953654426781444,
    "min_cos_tilt": 0.9996253713706428,
    "min_support_margin_m": 0.07417349186109062,
    "final_margin_m": 0.09333482361962155
  },
  "torque_ratio_ge_0.8_of_rated": {
    "stand": {},
    "squat_knee90": {
      "l_knee": {
        "tau_nm": 50.19,
        "class": "RS04",
        "rated_nm": 40.0,
        "ratio_rated": 1.255,
        "rating_verified": true
      },
      "r_knee": {
        "tau_nm": 50.19,
        "class": "RS04",
        "rated_nm": 40.0,
        "ratio_rated": 1.255,
        "rating_verified": true
      }
    },
    "arm_2kg_forward_reach": {
      "l_wrist_pitch": {
        "tau_nm": 3.03,
        "class": "WRIST_TBD",
        "rated_nm": 3.0,
        "ratio_rated": 1.008,
        "rating_verified": false
      }
    }
  }
}
```
