jitendraphand/ziggy/(commit log)

2026-11-07 ZIGGY v0.1.0: parametric CAD (20 STEP/STL parts), MuJoCo model, IK/stance/torque tests, BOM, wiring, safety, recursive QA
    [actuator_cover_ak80.step, actuator_cover_ak80.stl, cable_clip_tube40.step, cable_clip_tube40.stl, coupon_holes.step, coupon_holes.stl, coupon_tube_fit.step, coupon_tube_fit.stl]
2026-11-07 v0.1.1 simulation: headless MuJoCo renders, push sweeps (PD vs ankle strategy) with fall/recovery detection, IK media, assembled/exploded CAD views; fix ctrlrange radians (F-007), topple detection (F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
    [actuator_cover_ak80.step, cable_clip_tube40.step, coupon_holes.step, coupon_tube_fit.step, estop_mount.step, foot_cover.step, foot_sole_pad.step, forearm_cover_half.step]
2026-11-07 sim: fix F-008 body proxies passing through floor during falls; trajectory integrity checks + tests; visible push marker and wider fall camera
    [actuator_cover_ak80.step, cable_clip_tube40.step, coupon_holes.step, coupon_tube_fit.step, estop_mount.step, foot_cover.step, foot_sole_pad.step, forearm_cover_half.step]
2026-11-07 v0.2 lower body (experimental): integrated pelvis + 2x6-DoF dual-support yoke legs, sourced AK80-64 interfaces, bearings, pin/slot stops, per-part STEP/STL + manifest/BoM, hand calcs, derived enginee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
    [AP-ACT-L.step, AP-ARA-L.step, AP-ARA-L.stl, AP-ARB-L.step, AP-ARB-L.stl, AP-BCOV-L.step, AP-BCOV-L.stl, AP-BRG-L.step]
